AB-TheCoder/My_TechPad/Documentation/Notes.txt

This the notes file where i will keep track of the work i do , and things i cant/need not fit in my big brain
------------------------------------------------------------------------------------------------------------

15/10;2026
aim:start building the pcb,learn all stuff
report:
notes:
