AB-TheCoder/My_TechPad/Documentation/drawings/section.png

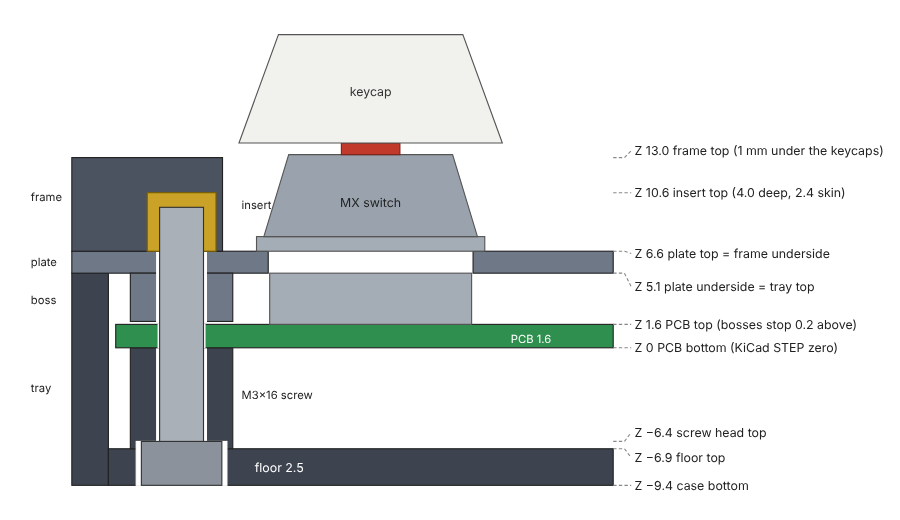
Documentation/drawings/section.png
