AB-TheCoder/My_TechPad/Documentation/drawings/TechPad_Frame_plan.png

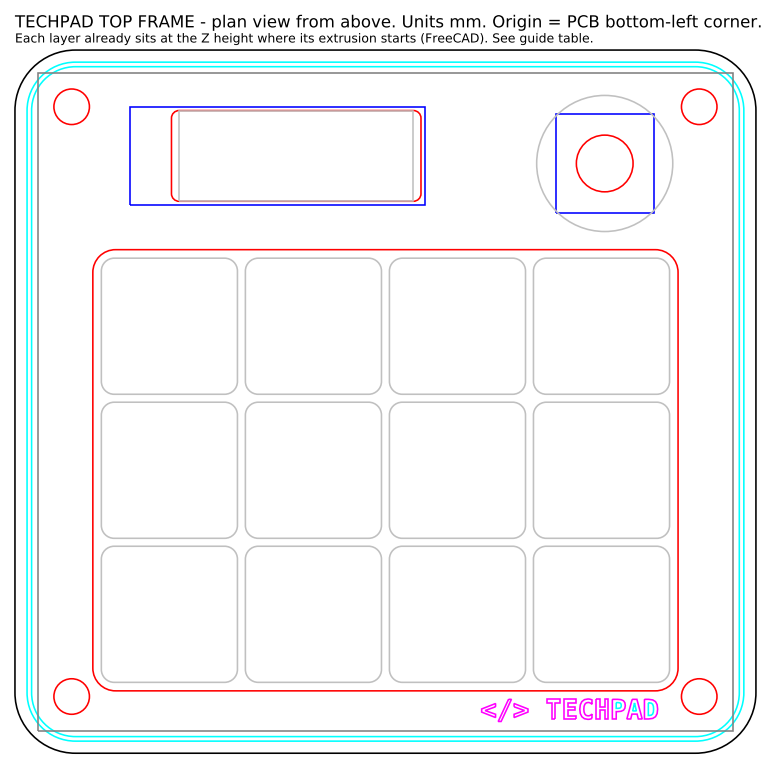
Documentation/drawings/TechPad_Frame_plan.png
