AB-TheCoder/My_TechPad/Documentation/drawings/TechPad_PCB_reference.png

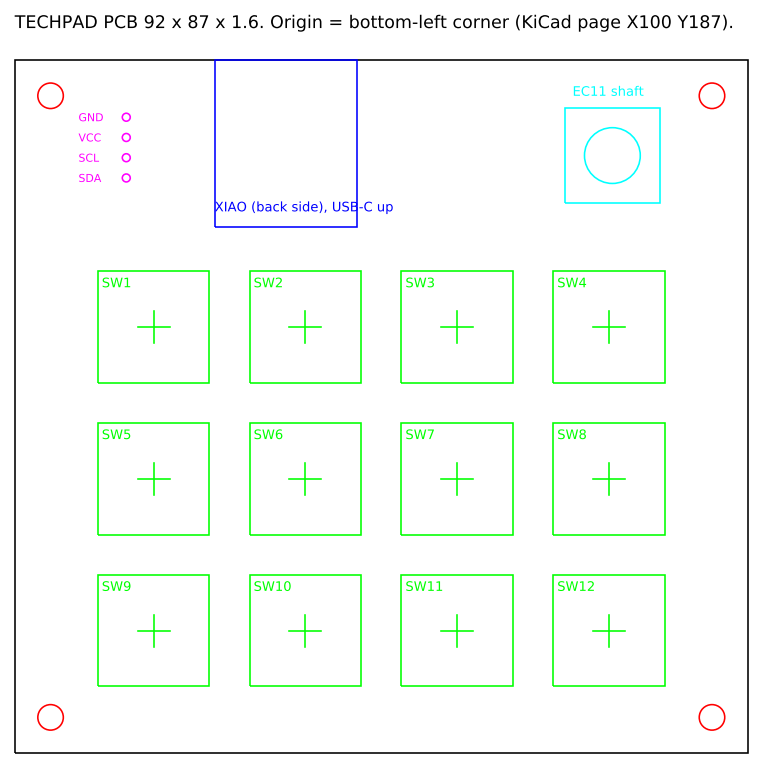
Documentation/drawings/TechPad_PCB_reference.png
