AB-TheCoder/My_TechPad/Documentation/drawings/TechPad_Plate_plan.png

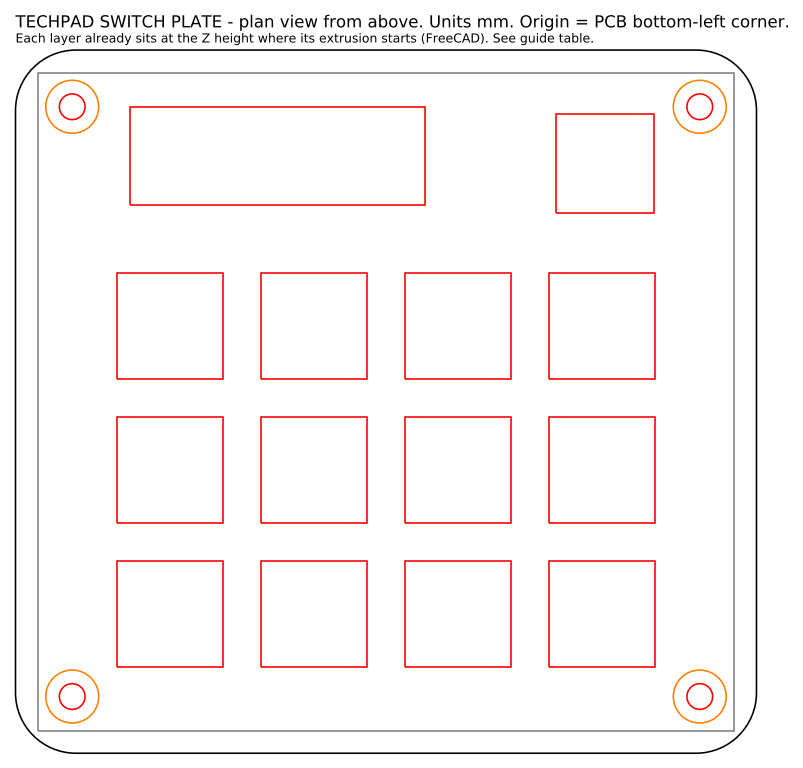
Documentation/drawings/TechPad_Plate_plan.png
