AB-TheCoder/My_TechPad/Documentation/drawings/TechPad_Tray_plan.png

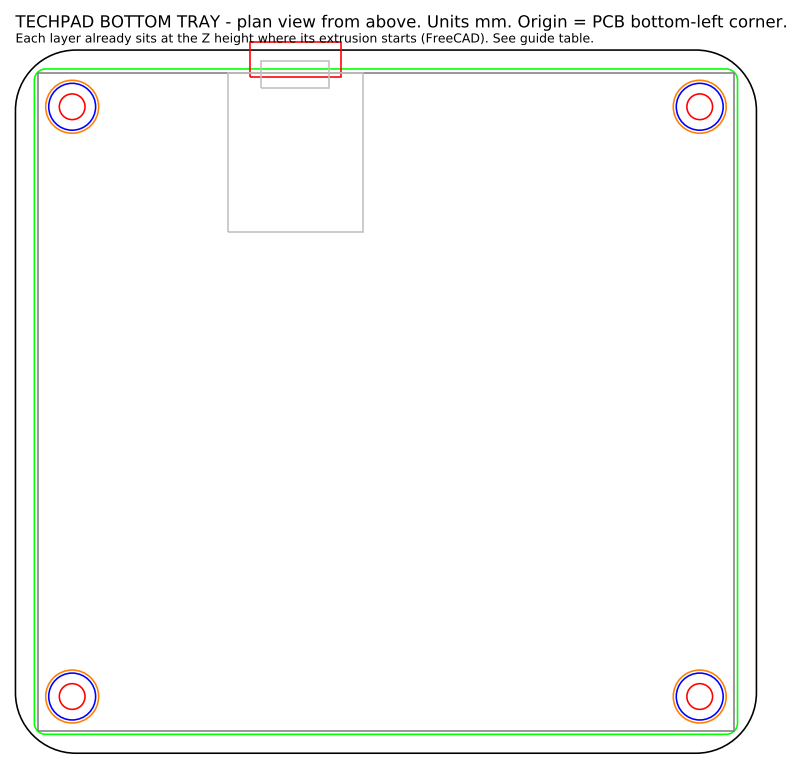
Documentation/drawings/TechPad_Tray_plan.png
