AB-TheCoder/My_TechPad/Documentation/images/pcb-routing-v2.png

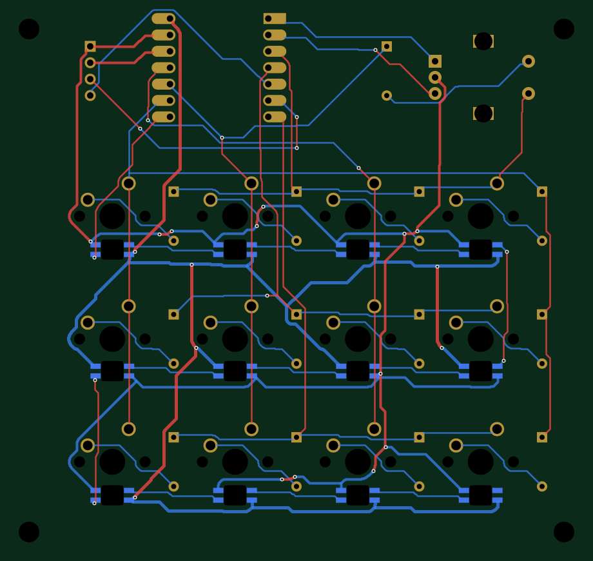
Documentation/images/pcb-routing-v2.png
