AB-TheCoder/My_TechPad/Documentation/images/techpad-duplex-matrix-wired.png

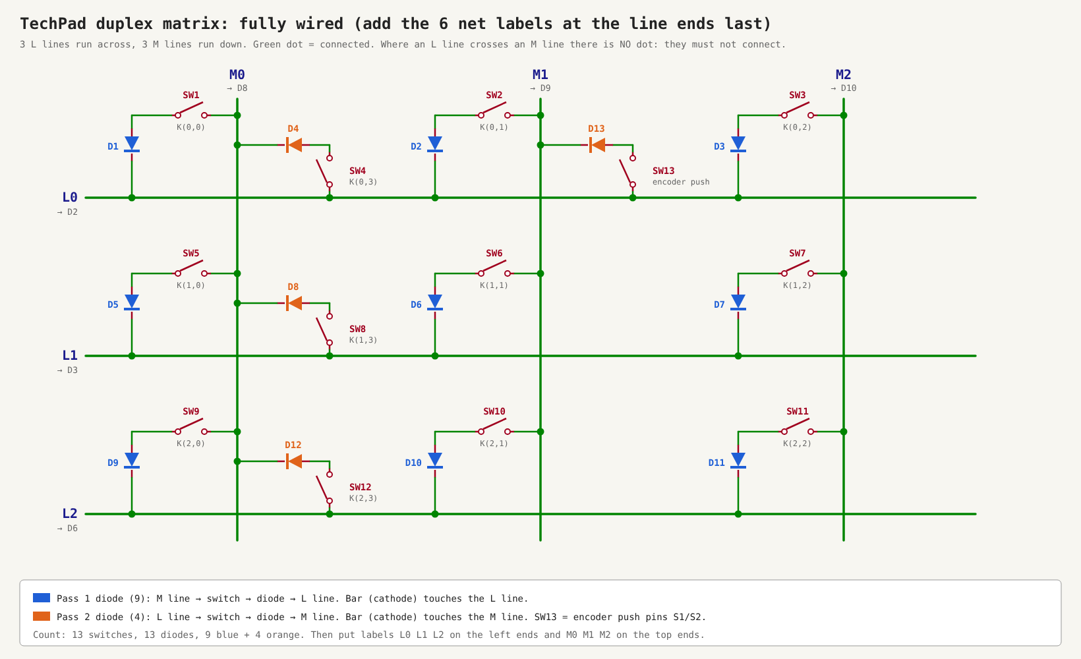
Documentation/images/techpad-duplex-matrix-wired.png
