AB-TheCoder/My_TechPad/Documentation/images/techpad-reference-schematic.png

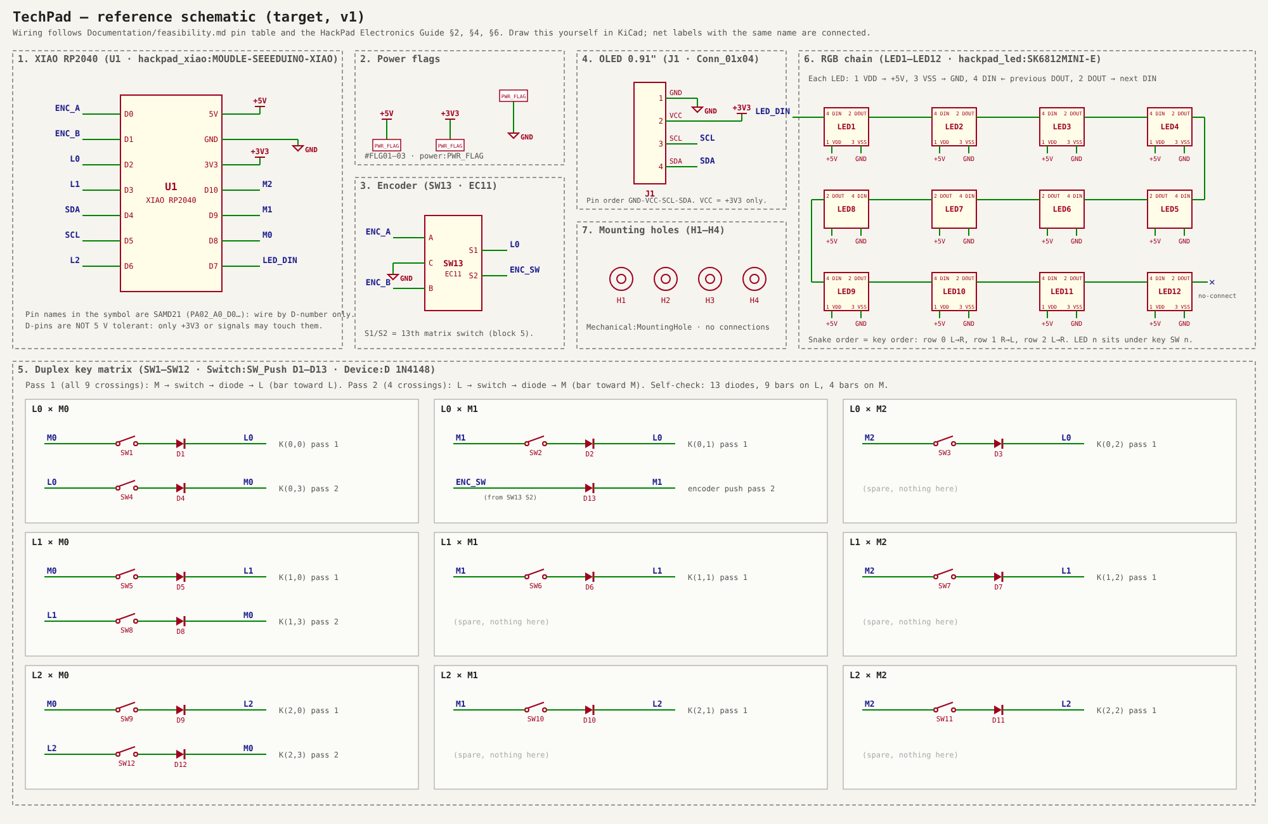
Documentation/images/techpad-reference-schematic.png
