AB-TheCoder/My_TechPad/CAD/Techpad-design(stlforrender).stl

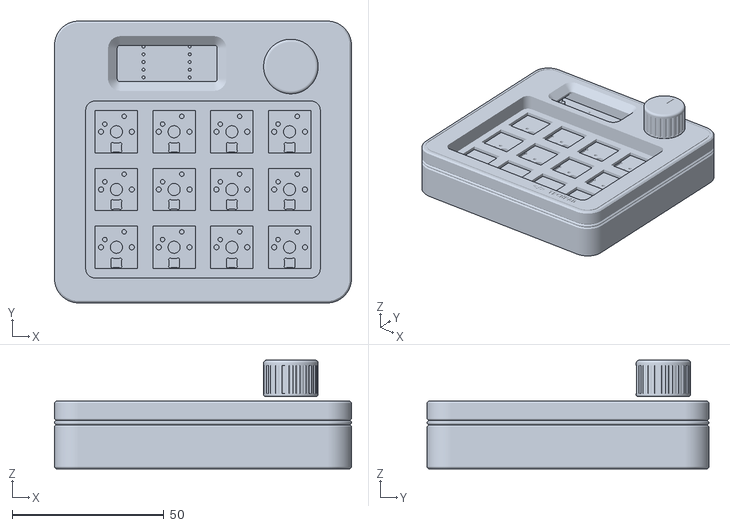
[picture p13: CAD file, 2026-11-10]
CAD/Techpad-design(stlforrender).stl
98.0 x 93.0 x 35.9
