AB-TheCoder/My_TechPad/Documentation/drawings/TechPad_PCB_reference.dxf

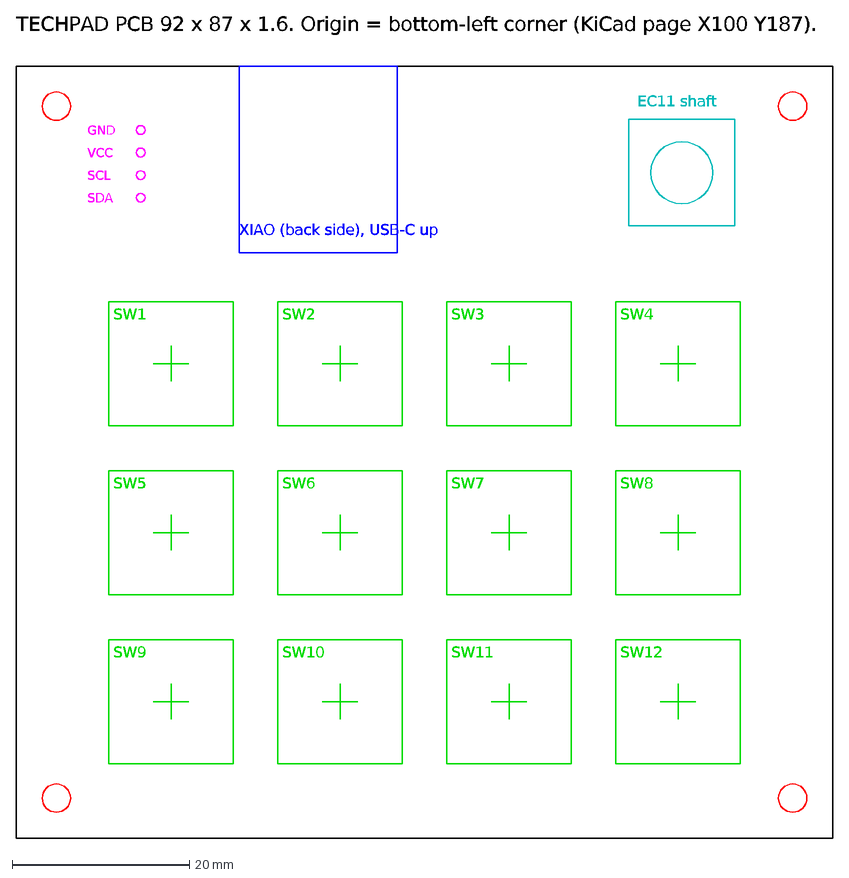
[picture p14: CAD file, 2026-10-20]
Documentation/drawings/TechPad_PCB_reference.dxf
SW1
SW2
SW3
SW4
SW5
SW6
SW7
SW8
SW9
SW10
SW11
SW12
EC11 shaft
GND
VCC
SCL
SDA
XIAO (back side), USB-C up
TECHPAD PCB 92 x 87 x 1.6. Origin = bottom-left corner (KiCad page X100 Y187).
