AB-TheCoder/My_TechPad/Production/designs/Plate-final.step

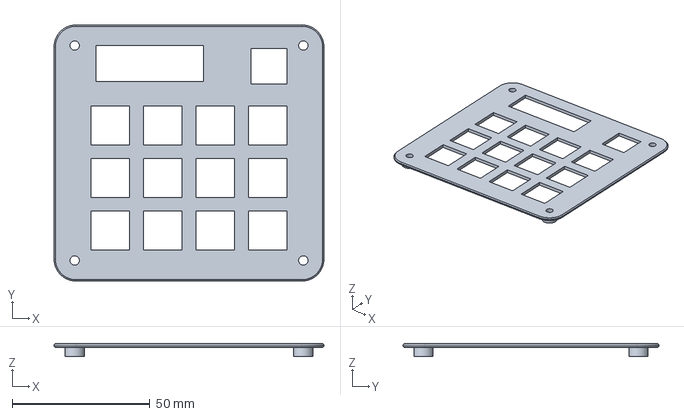
[picture p15: CAD file, 2026-10-20]
Production/designs/Plate-final.step
98.0 x 93.0 x 4.80 mm
