AB-TheCoder/My_TechPad/CAD/kNob_cap-Final.step

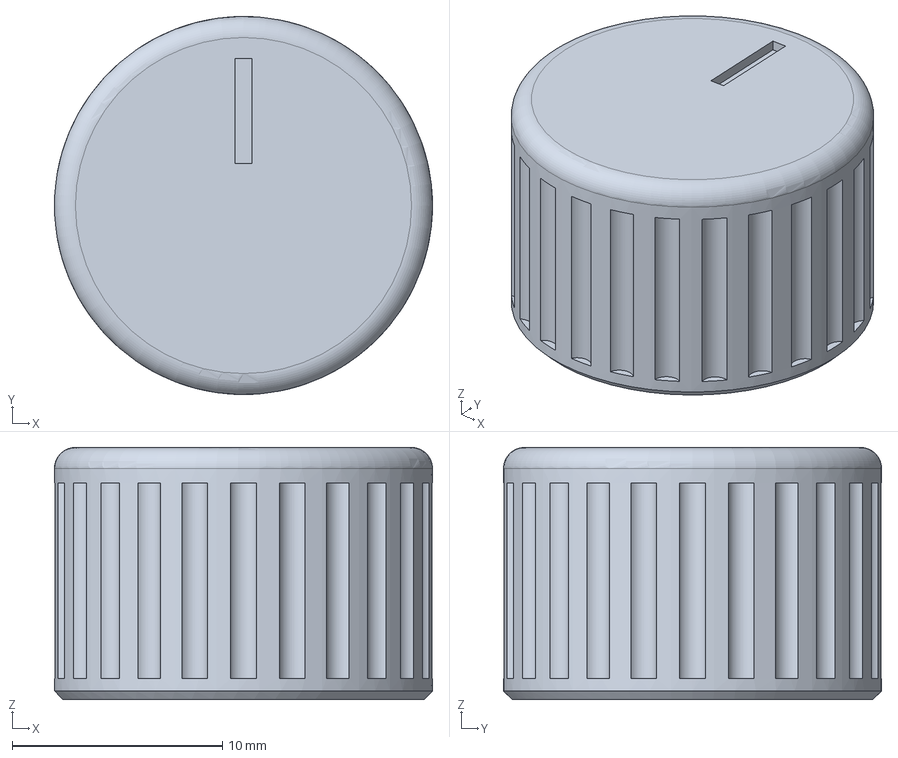
[picture p16: CAD file, 2026-10-20]
CAD/kNob_cap-Final.step
18.0 x 18.0 x 12.0 mm
