AB-TheCoder/My_TechPad/Documentation/drawings/TechPad_Tray_plan.dxf

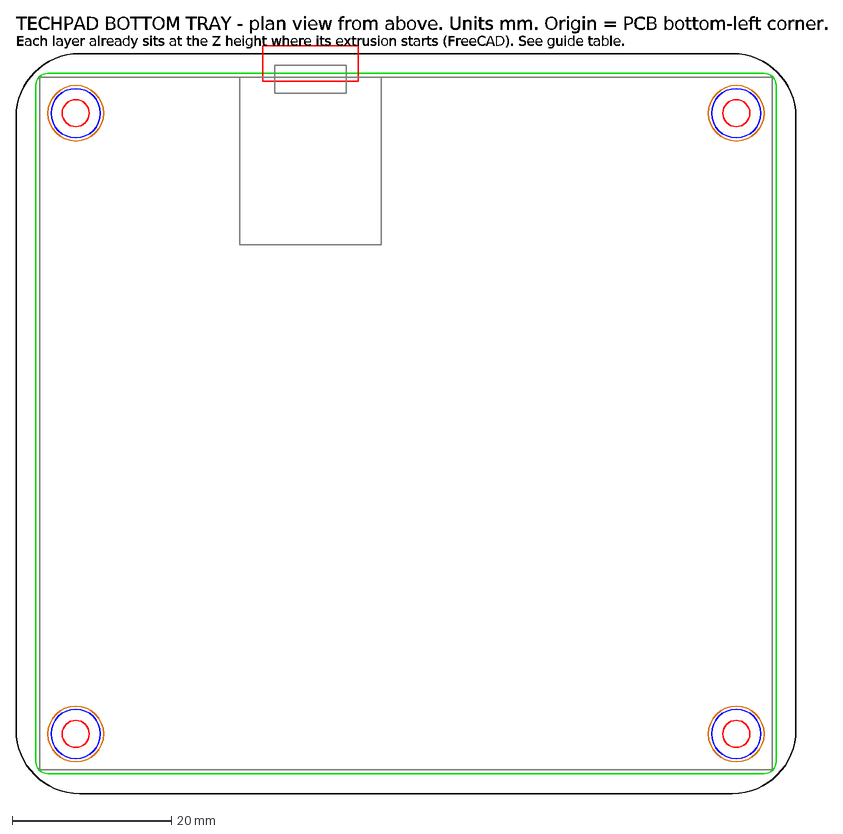
[picture p17: CAD file, 2026-10-20]
Documentation/drawings/TechPad_Tray_plan.dxf
TECHPAD BOTTOM TRAY - plan view from above. Units mm. Origin = PCB bottom-left corner.
Each layer already sits at the Z height where its extrusion starts (FreeCAD). See guide table.
