AB-TheCoder/My_TechPad/Production/designs/pcb.step

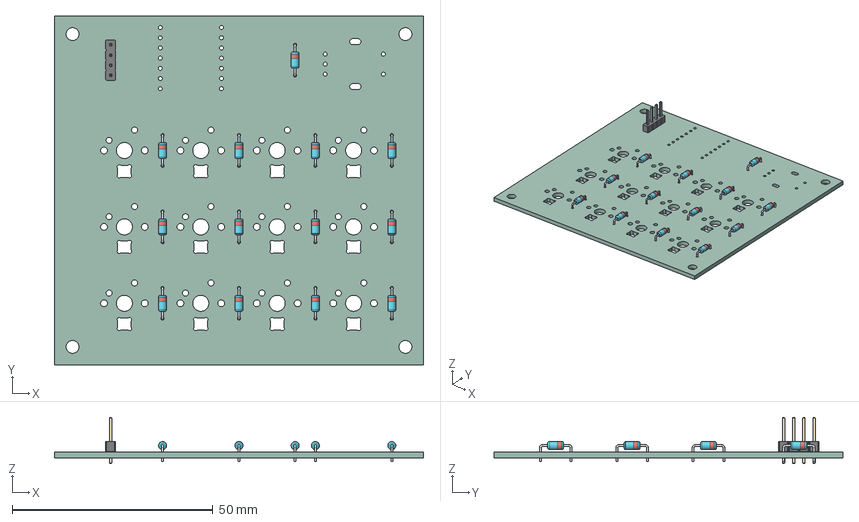
[picture p18: CAD file, 2026-10-20]
Production/designs/pcb.step
92.0 x 87.0 x 11.5 mm
D_DO-35_SOD27_P7.62mm_Horizontal x 13
PinHeader_1x04_P254mm_Vertical
pcb_PCB
