AB-TheCoder/My_TechPad/Documentation/drawings/TechPad_Frame_plan.dxf

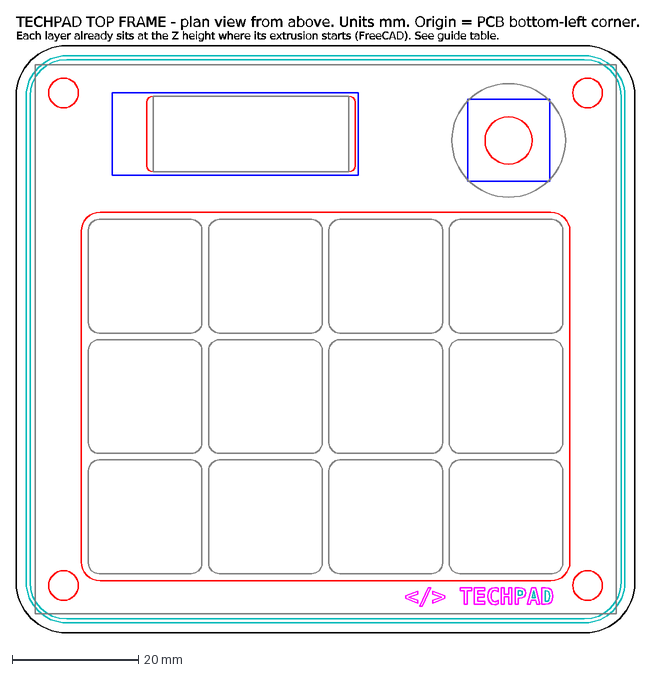
[picture p19: CAD file, 2026-10-20]
Documentation/drawings/TechPad_Frame_plan.dxf
TECHPAD TOP FRAME - plan view from above. Units mm. Origin = PCB bottom-left corner.
Each layer already sits at the Z height where its extrusion starts (FreeCAD). See guide table.
