AB-TheCoder/My_TechPad/CAD/frame.FCStd

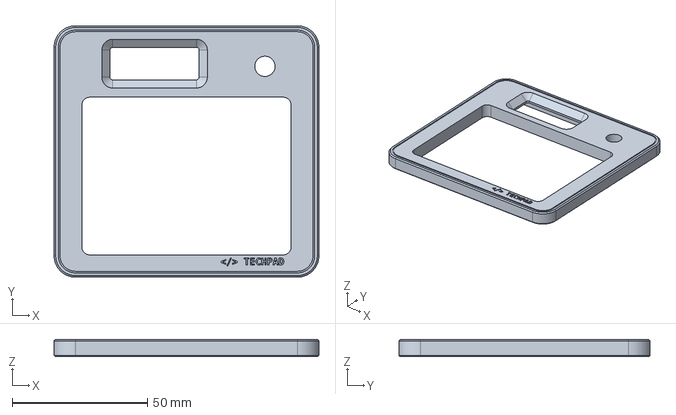
[picture p20: CAD file, 2026-10-20]
CAD/frame.FCStd
98.0 x 93.0 x 6.40 mm
