AB-TheCoder/My_TechPad/Production/designs/Tray-Final.step

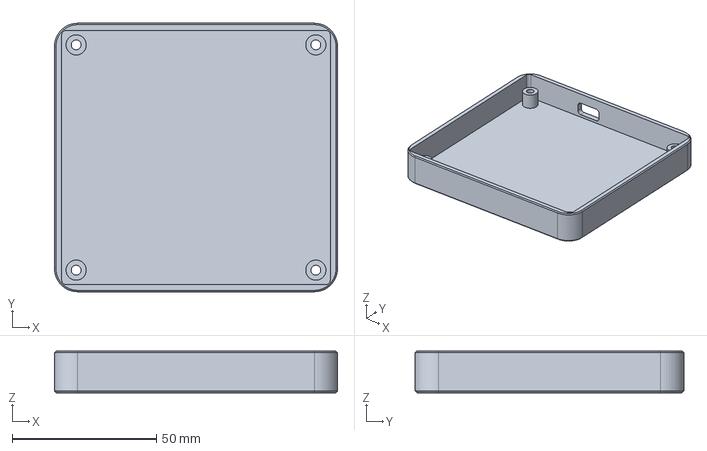
[picture p22: CAD file, 2026-10-20]
Production/designs/Tray-Final.step
98.0 x 93.0 x 14.5 mm
