AB-TheCoder/My_TechPad/CAD/Tray.FCStd

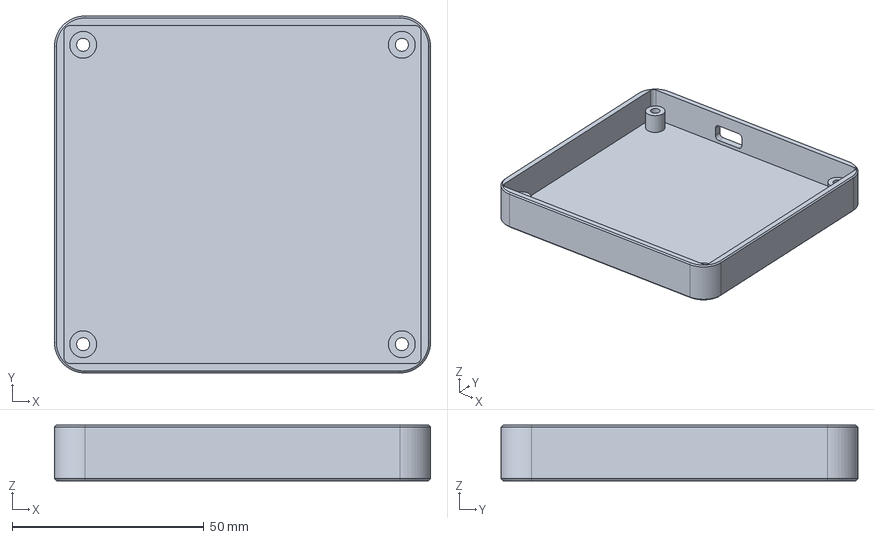
[picture p23: CAD file, 2026-10-20]
CAD/Tray.FCStd
98.0 x 93.0 x 14.5 mm
