AB-TheCoder/My_TechPad/(list of files, cad)

Other CAD files:
CAD/Techpad-design.FCStd
Production/designs/TechPad-final.step
CAD/kNob_cap.FCStd
CAD/TechPad-final.step
Production/designs/frame-Final.step
CAD/frame-Final.step
CAD/Plate.FCStd
