AB-TheCoder/My_TechPad/PCB/pcb.kicad_pcb

## KiCad design PCB/pcb.kicad_pcb (2026-10-20)

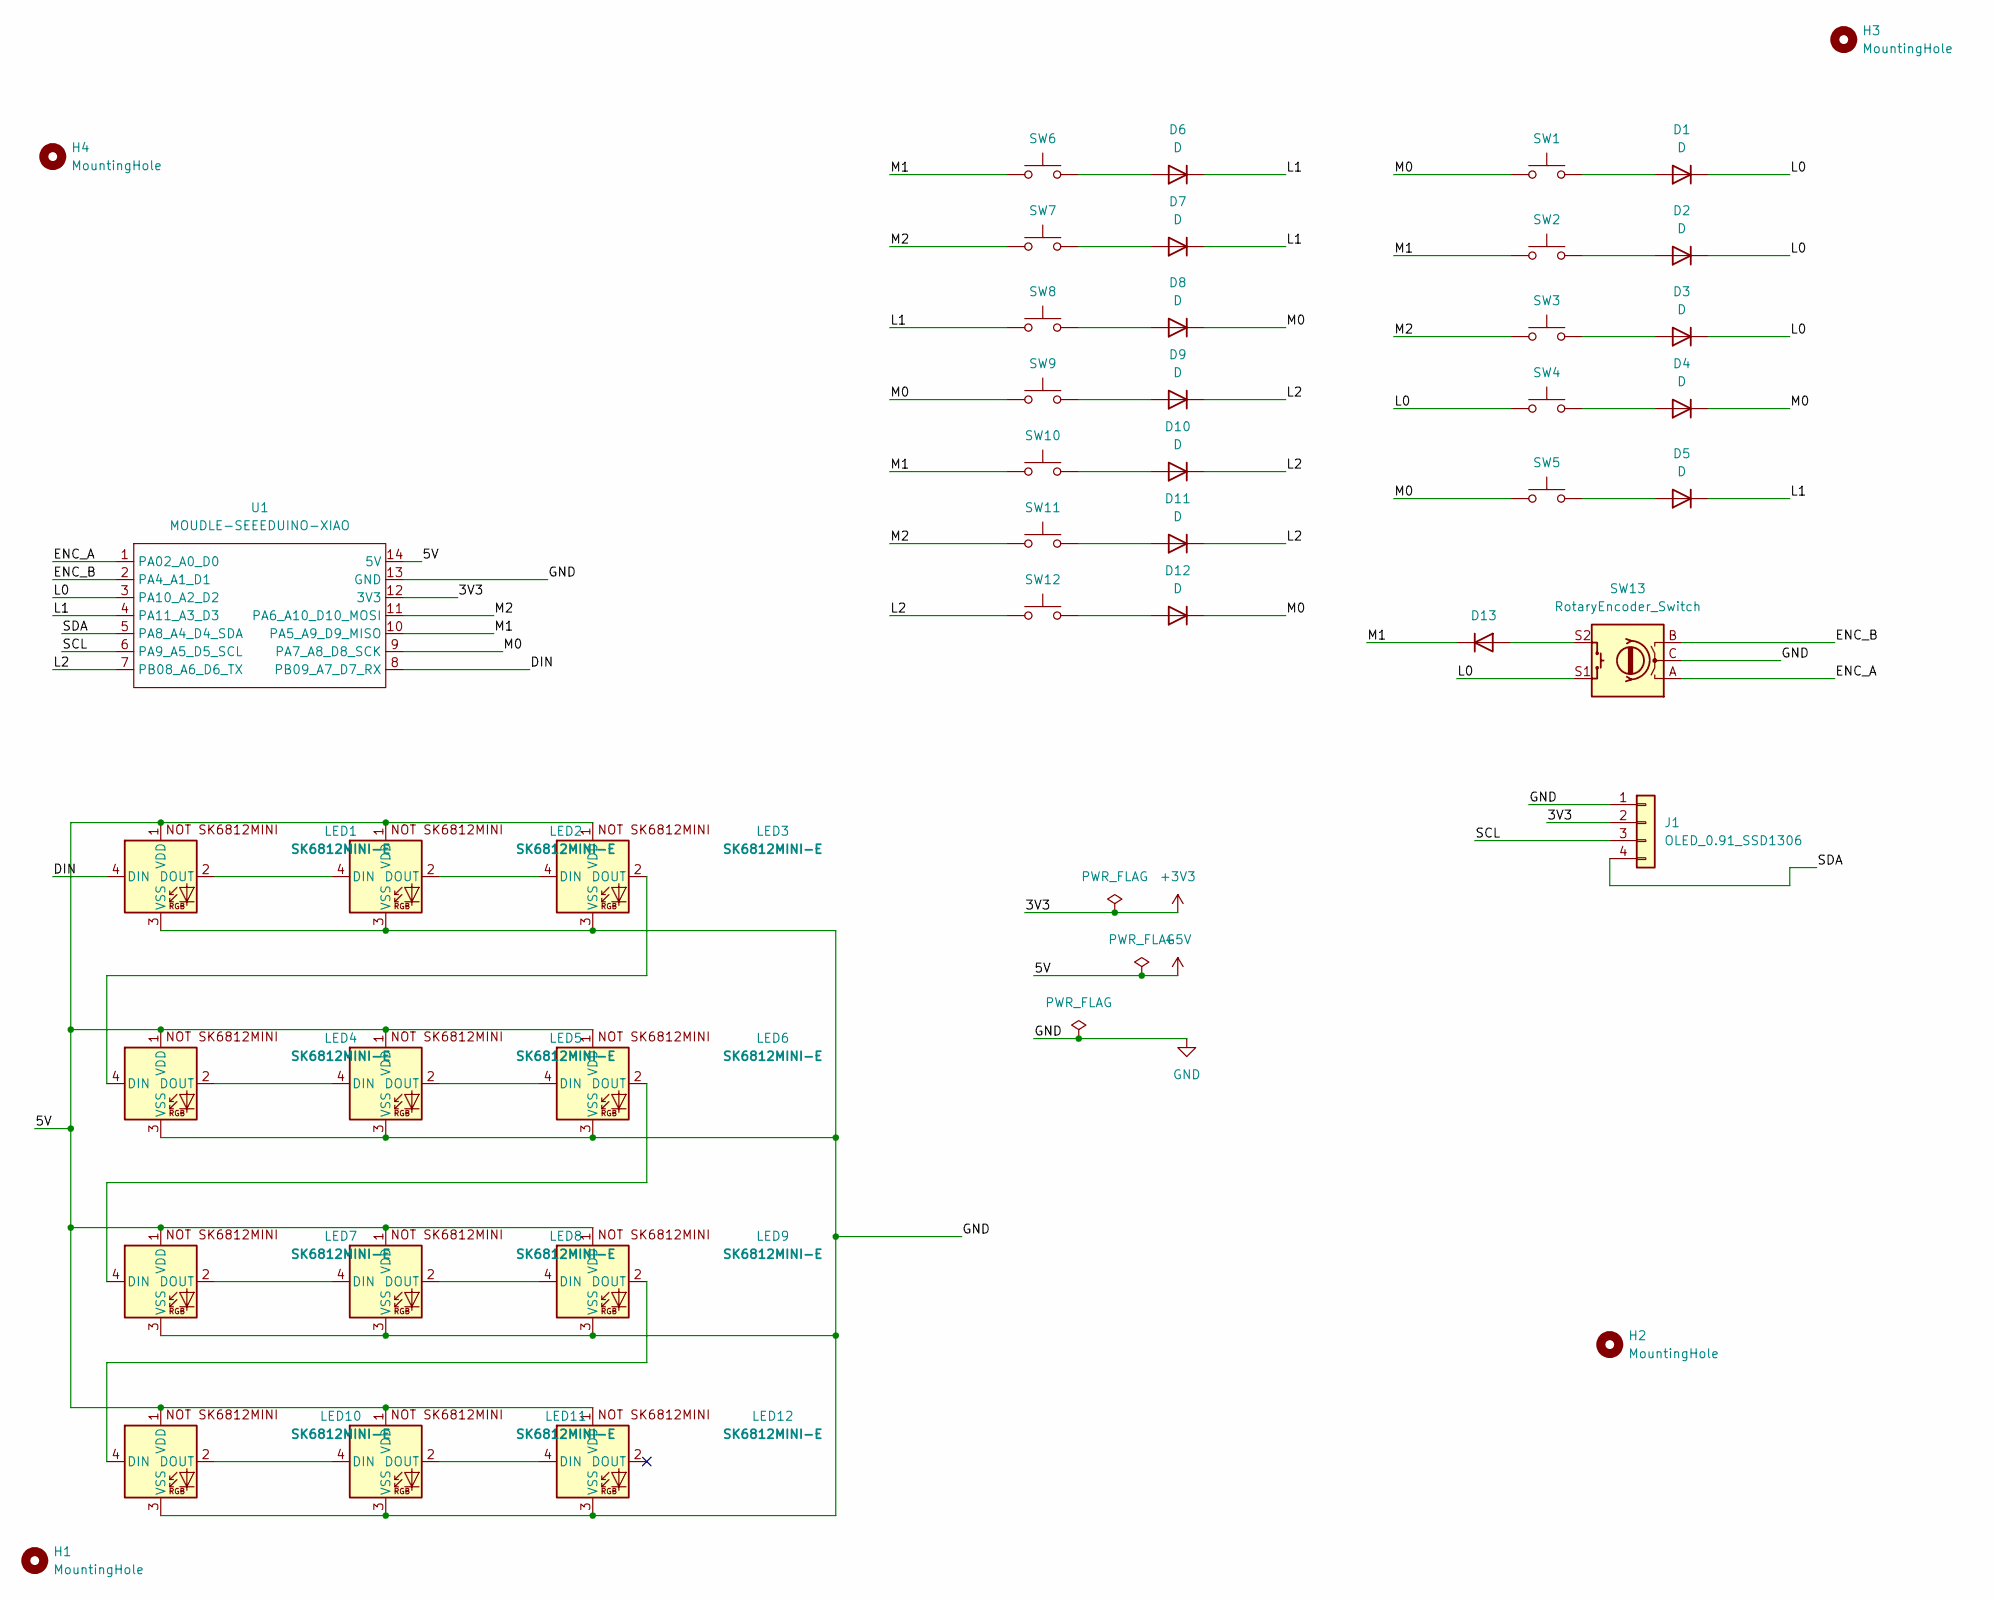
[picture p24: schematic pcb.kicad_sch, TechPad]

Parts:
D1, D2, D3, D4, D5, D6, D7, D8, D9, D10, D11, D12, D13: D; D_DO-35_SOD27_P7.62mm_Horizontal
H1, H2, H3, H4: MountingHole; MountingHole_3.2mm_M3
J1: OLED_0.91_SSD1306; PinHeader_1x04_P2.54mm_Vertical
LED1, LED2, LED3, LED4, LED5, LED6, LED7, LED8, LED9, LED10, LED11, LED12: SK6812MINI-E; SK6812MINI-E_fixed
SW1, SW2, SW3, SW4, SW5, SW6, SW7, SW8, SW9, SW10, SW11, SW12: SW_Push; SW_Cherry_MX_1.00u_PCB
SW13: RotaryEncoder_Switch; RotaryEncoder_Alps_EC11E-Switch_Vertical_H20mm
U1: MOUDLE-SEEEDUINO-XIAO; XIAO-Generic-Hybrid-14P-2.54-21X17.8MM

Connections:
+3V3: J1.2, U1.12 (3V3)
+5V: LED1.1 (VDD), LED2.1 (VDD), LED3.1 (VDD), LED4.1 (VDD), LED5.1 (VDD), LED6.1 (VDD), LED7.1 (VDD), LED8.1 (VDD), LED9.1 (VDD), LED10.1 (VDD), LED11.1 (VDD), LED12.1 (VDD), U1.14 (5V)
/DIN: LED1.4 (DIN), U1.8 (PB09_A7_D7_RX)
/ENC_A: SW13.A, U1.1 (PA02_A0_D0)
/ENC_B: SW13.B, U1.2 (PA4_A1_D1)
/L0: D1.1 (K), D2.1 (K), D3.1 (K), SW4.1, SW13.S1, U1.3 (PA10_A2_D2)
/L1: D5.1 (K), D6.1 (K), D7.1 (K), SW8.1, U1.4 (PA11_A3_D3)
/L2: D9.1 (K), D10.1 (K), D11.1 (K), SW12.1, U1.7 (PB08_A6_D6_TX)
/M0: D4.1 (K), D8.1 (K), D12.1 (K), SW1.1, SW5.1, SW9.1, U1.9 (PA7_A8_D8_SCK)
/M1: D13.1 (K), SW2.1, SW6.1, SW10.1, U1.10 (PA5_A9_D9_MISO)
/M2: SW3.1, SW7.1, SW11.1, U1.11 (PA6_A10_D10_MOSI)
/SCL: J1.3, U1.6 (PA9_A5_D5_SCL)
/SDA: J1.4, U1.5 (PA8_A4_D4_SDA)
GND: J1.1, LED1.3 (VSS), LED2.3 (VSS), LED3.3 (VSS), LED4.3 (VSS), LED5.3 (VSS), LED6.3 (VSS), LED7.3 (VSS), LED8.3 (VSS), LED9.3 (VSS), LED10.3 (VSS), LED11.3 (VSS), LED12.3 (VSS), SW13.C, U1.13 (GND)
unnamed: D1.2 (A), SW1.2
unnamed: D2.2 (A), SW2.2
unnamed: D3.2 (A), SW3.2
unnamed: D4.2 (A), SW4.2
unnamed: D5.2 (A), SW5.2
unnamed: D6.2 (A), SW6.2
unnamed: D7.2 (A), SW7.2
unnamed: D8.2 (A), SW8.2
unnamed: D9.2 (A), SW9.2
unnamed: D10.2 (A), SW10.2
unnamed: D11.2 (A), SW11.2
unnamed: D12.2 (A), SW12.2
unnamed: D13.2 (A), SW13.S2
unnamed: LED1.2 (DOUT), LED2.4 (DIN)
unnamed: LED2.2 (DOUT), LED3.4 (DIN)
unnamed: LED3.2 (DOUT), LED4.4 (DIN)
unnamed: LED4.2 (DOUT), LED5.4 (DIN)
unnamed: LED5.2 (DOUT), LED6.4 (DIN)
unnamed: LED6.2 (DOUT), LED7.4 (DIN)
unnamed: LED7.2 (DOUT), LED8.4 (DIN)
unnamed: LED8.2 (DOUT), LED9.4 (DIN)
unnamed: LED9.2 (DOUT), LED10.4 (DIN)
unnamed: LED10.2 (DOUT), LED11.4 (DIN)
unnamed: LED11.2 (DOUT), LED12.4 (DIN)

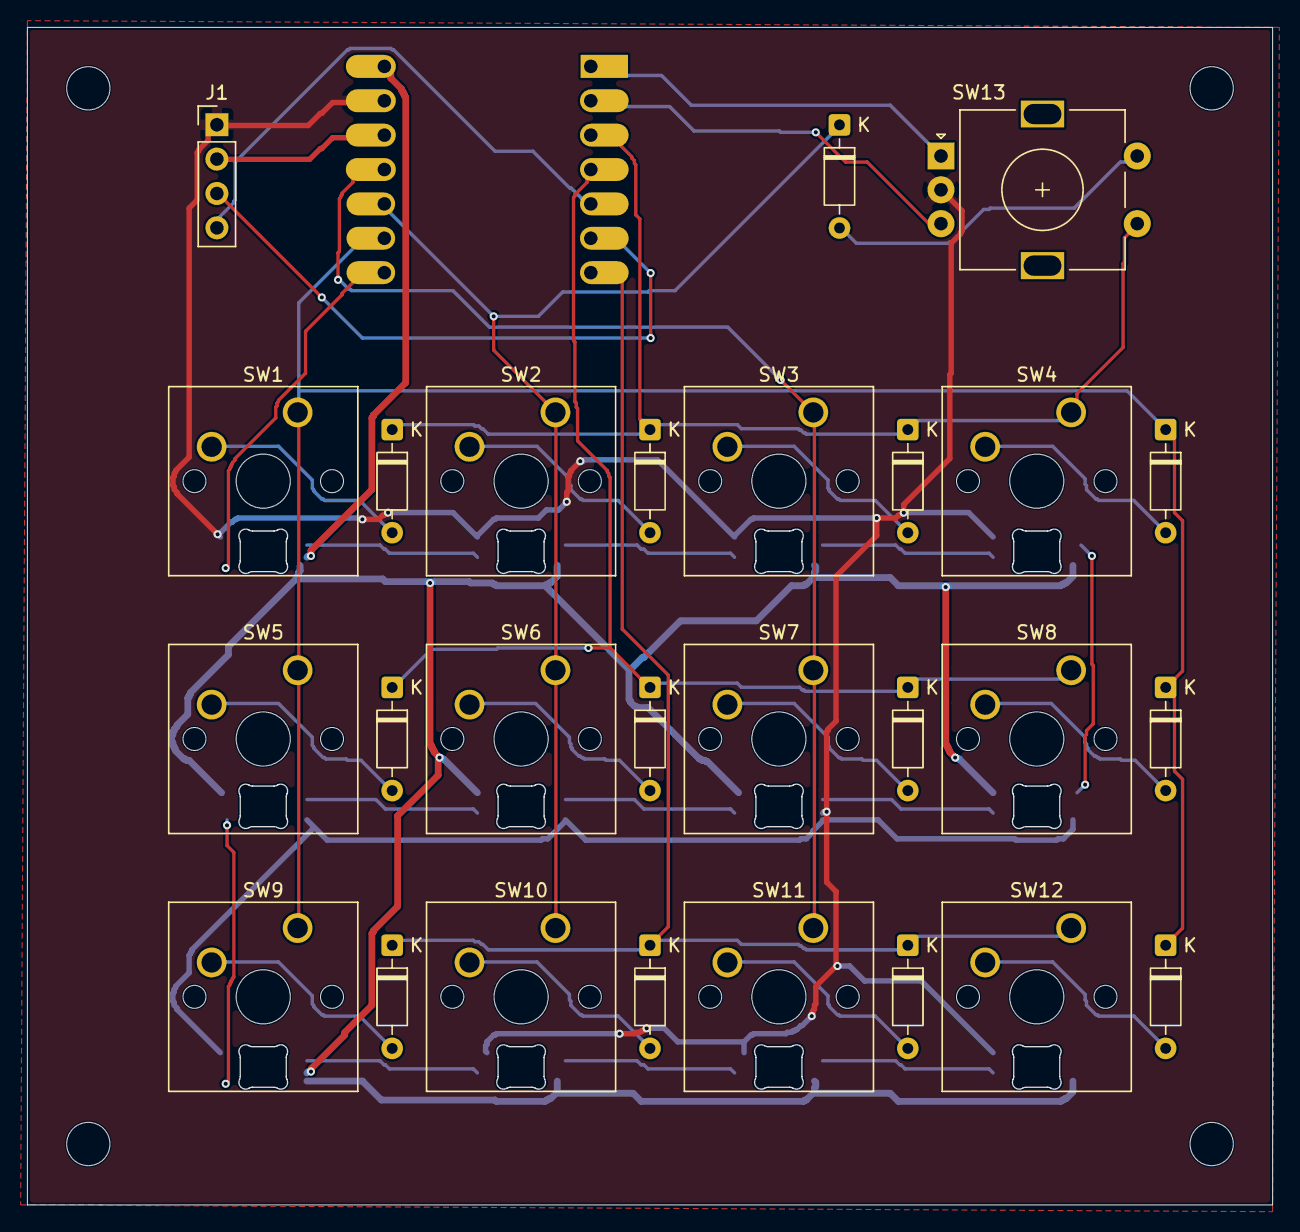
[picture p25: board pcb.kicad_pcb from above]

Board: 2 copper layers, 92.0 x 87.0 mm, 44 parts (1 on the bottom side), 38 nets.
