AB-TheCoder/My_TechPad/Firmware/techpad/config.h

// Copyright 2026 Aarav bhatt(MoonRock)
// SPDX-License-Identifier: GPL-2.0-or-later

#pragma once
//oled is on I2C1: gp6=sda,gp7=scl. defining the properties
#define I2C_DRIVER I2CD1
#define I2C1_SDA_PIN GP6
#define I2C1_SCL_PIN GP7
