AB-TheCoder/My_TechPad/(commit log)

2026-10-16 Add Milestone 1 feasibility and architecture doc
    Hackpad rules check, component check, GPIO budget with a duplex
    matrix (12 keys + 1 knob, kit parts only), pin allocation, firmware
    comparison (QMK + VIA recommended), power notes and open questions.
    Claude-Session: https://claude.ai/code/session_014o8KZtTNjViGp3oFPFixRH
2026-10-16 pcb uploadation
    [pcb.kicad_pcb, pcb.kicad_sch]
2026-10-19 Add initial PCB design files including schematic, layout, and library configurations for the TechPad project.
    [pcb.kicad_pcb, pcb.kicad_sch]
2026-10-19 Update .gitignore to include additional file patterns for KiCad and FreeCAD, remove obsolete entries, and add OS/editor specific ignores. Delete unused briefing.md and Notes.txt files to streamline p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
    [BOM.csv, Plate-final.step, Plate.FCStd, TechPad_Frame_plan.dxf, TechPad_PCB_reference.dxf, TechPad_Plate_plan.dxf, TechPad_Tray_plan.dxf, Techpad-design.FCStd]
2026-10-20 Remove unused .gitkeep file and enhance keyboard configuration in keyboard.json with encoder, OLED, and RGB matrix support. Update matrix.c for custom matrix scanning logic and improve keymap.c with 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
2026-10-20 Revise README.md to reflect updated project vision and specifications for the custom Macropad. Remove obsolete documentation files including briefing.md and feasibility.md, and delete various PDF gui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
    [BOM.csv, Plate-final.step, TechPad-final.step, TechPad_Frame_plan.dxf, TechPad_PCB_reference.dxf, TechPad_Plate_plan.dxf, TechPad_Tray_plan.dxf, Techpad-design.FCStd]
2026-10-20 Update README.md with detailed build instructions and enhance documentation on AI contributions. Add copyright headers to firmware files and correct minor typos in comments. Revise keymap.c copyright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
    [config.h, keymap.c, matrix.c]
2026-11-10 made the changes asked-deleted ai renders and made a new one myself.
    [Techpad-design(stlforrender).stl]
